ikhwanyoza/Thesis/pictures/15467.jpg

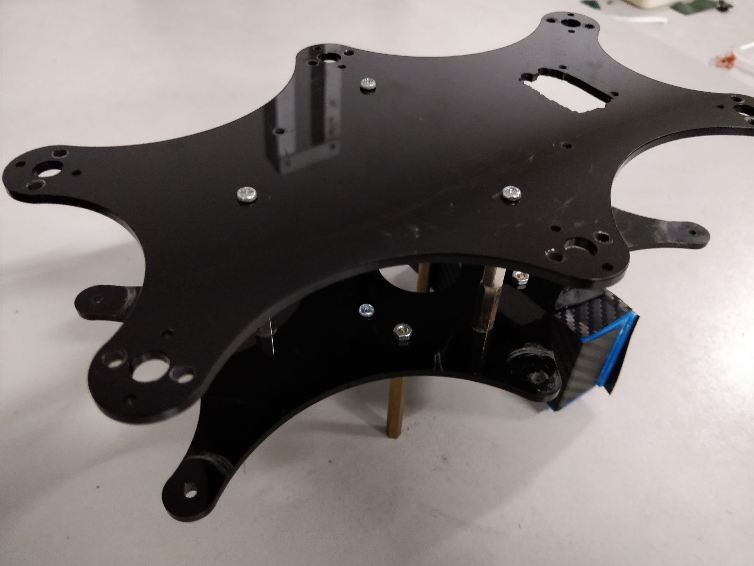
pictures/15467.jpg
