ikhwanyoza/Thesis/pictures/S__25133162.jpg

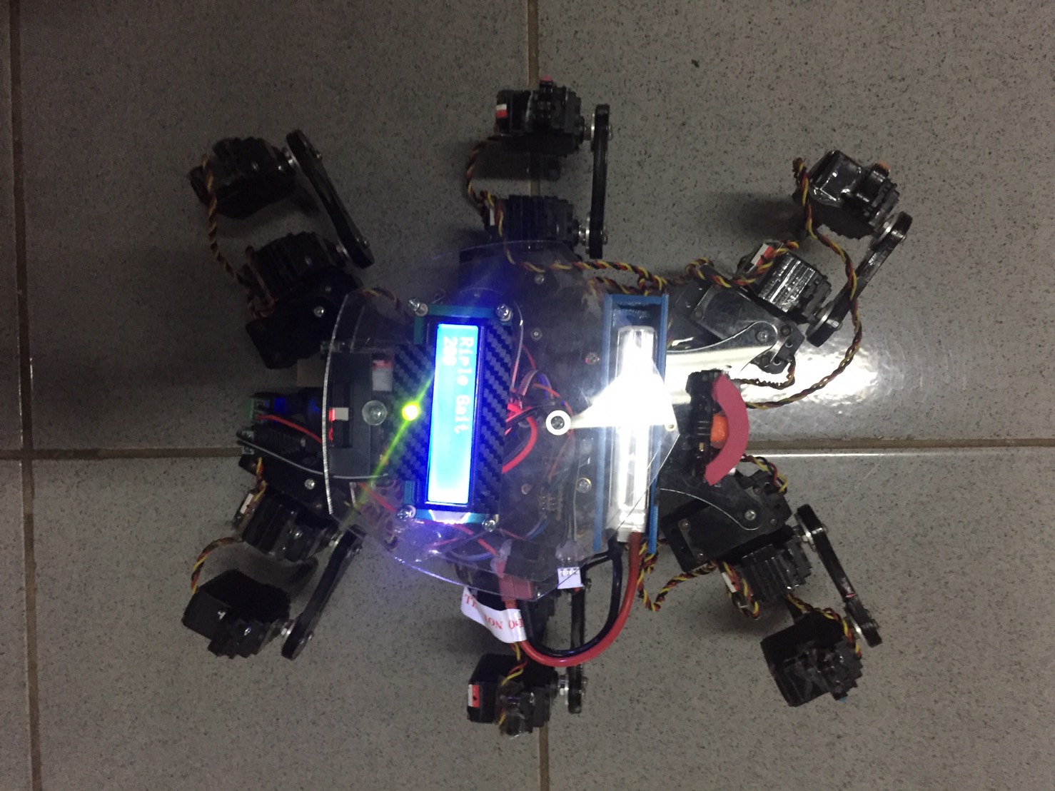
pictures/S__25133162.jpg
