ikhwanyoza/Thesis/pictures/15463.jpg

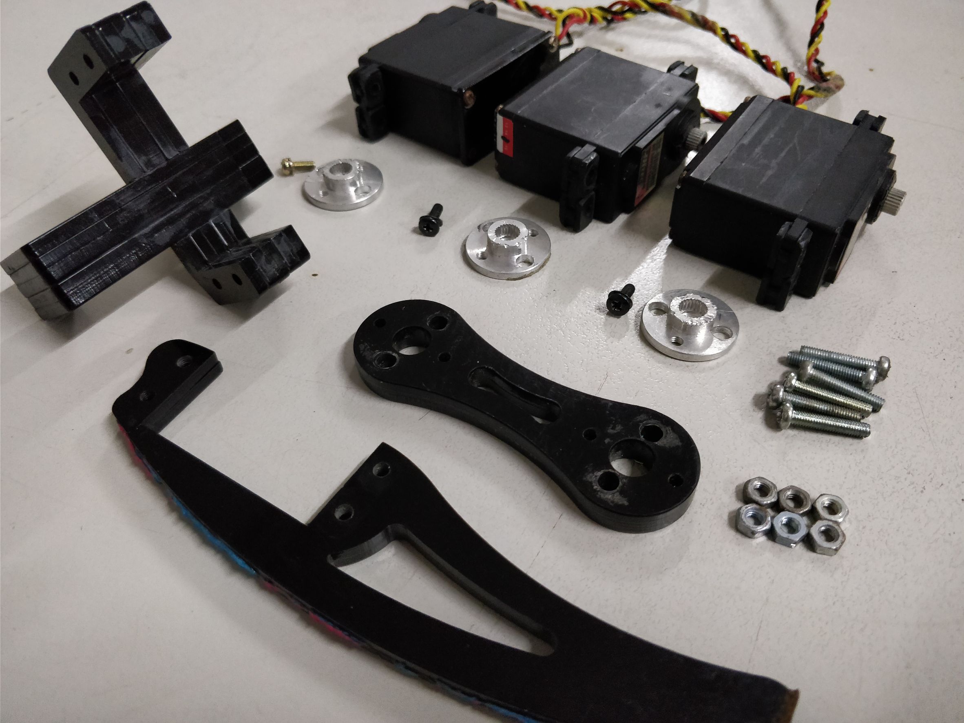
pictures/15463.jpg
