ikhwanyoza/Thesis/pictures/15465.jpg

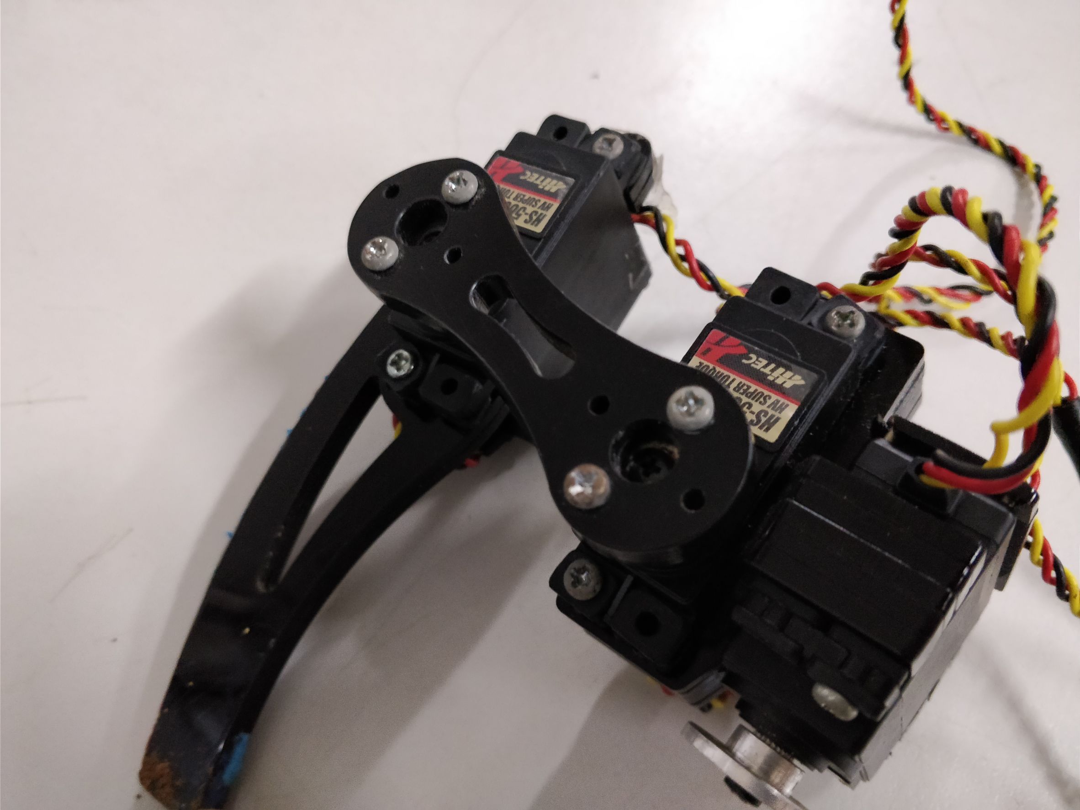
pictures/15465.jpg
