ikhwanyoza/Thesis/pictures/15470.jpg

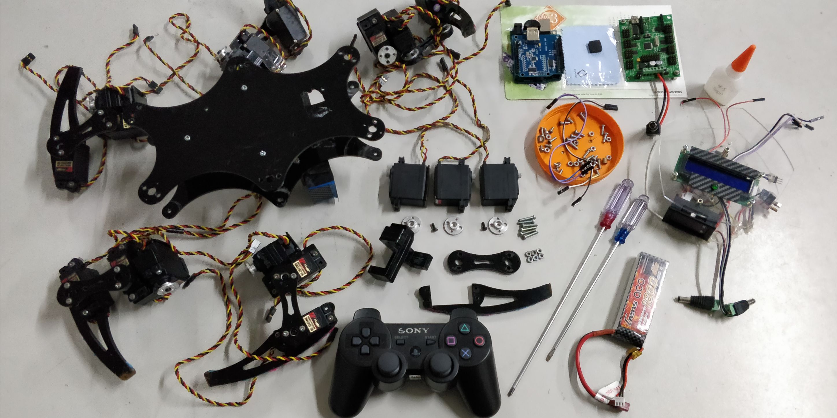
pictures/15470.jpg
