ikhwanyoza/Thesis/pictures/415351.jpg

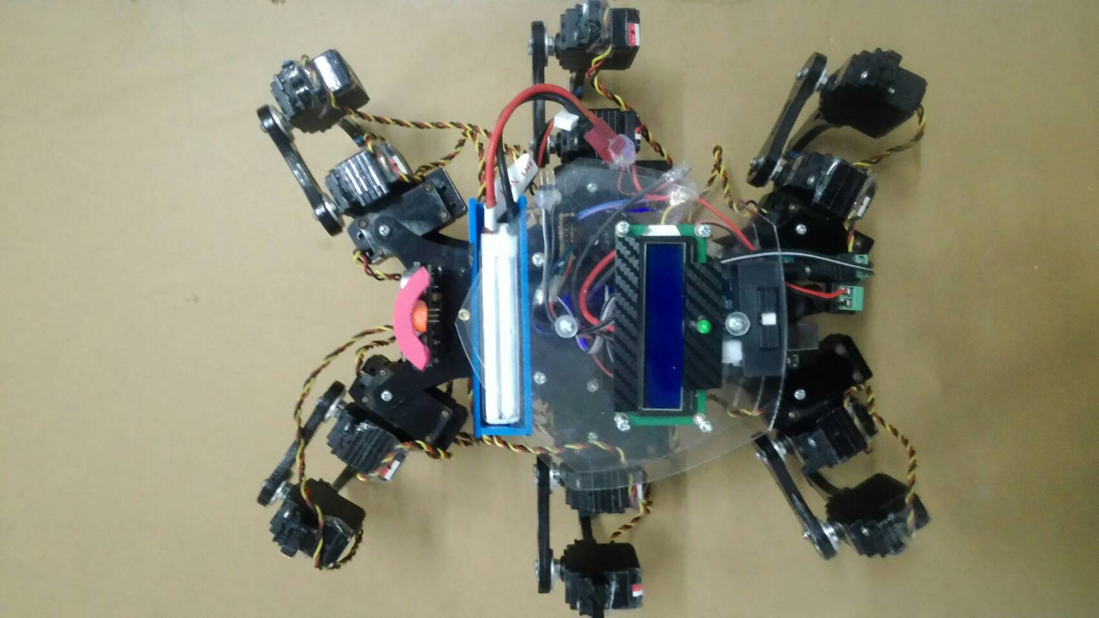
pictures/415351.jpg
