ikhwanyoza/Thesis/pictures/415352.jpg

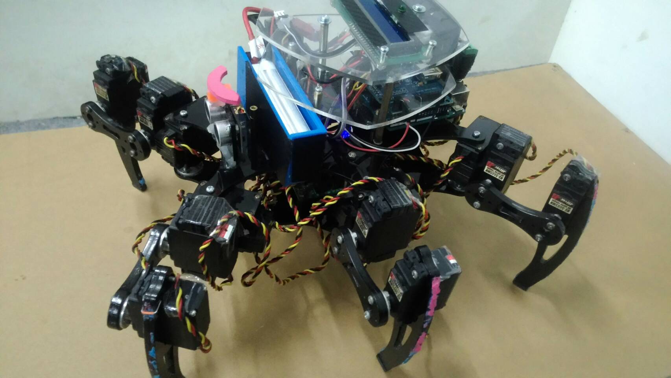
pictures/415352.jpg
