ikhwanyoza/Thesis/pictures/S__25133159.jpg

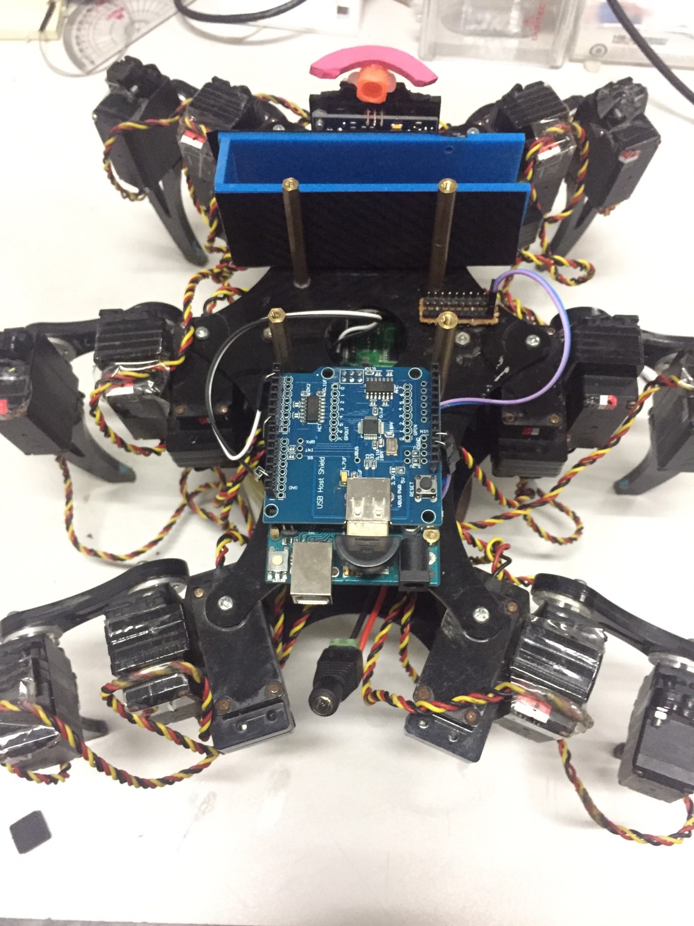
pictures/S__25133159.jpg
