ikhwanyoza/Thesis/pictures/S__25133160.jpg

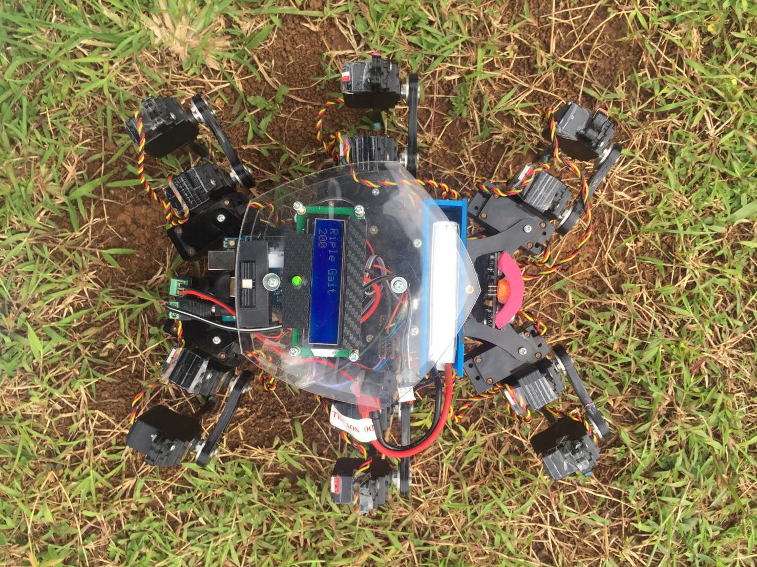
pictures/S__25133160.jpg
