ikhwanyoza/Thesis/pictures/S__25133161.jpg

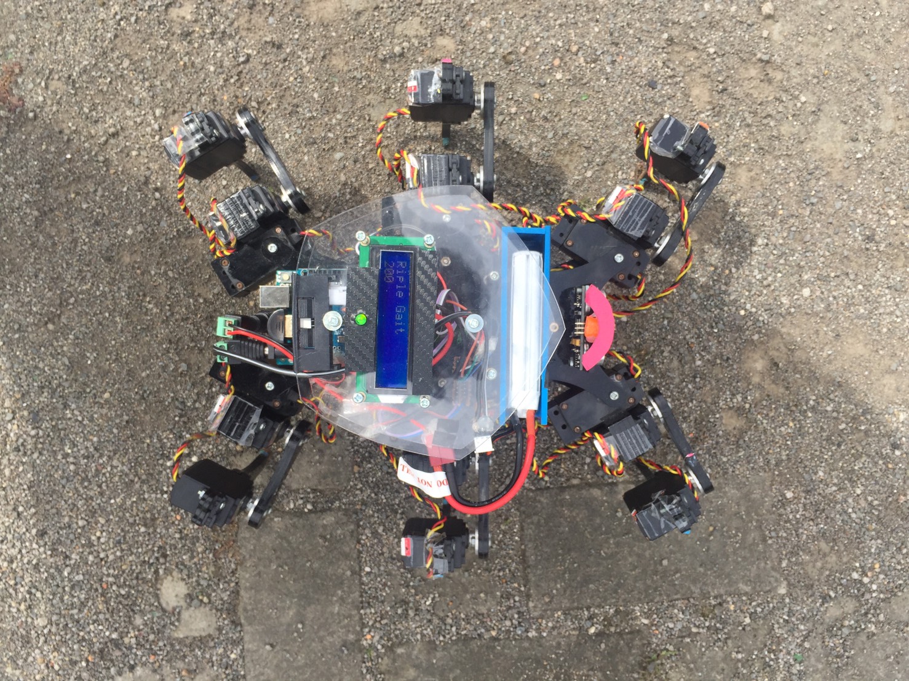
pictures/S__25133161.jpg
